piecesnsn/SRM_RoboMaster_Entropia/README.md

# SRM_RoboMaster_Entropia
In this repository, I will keep all the files ragarding SRM RoboMaster, team hardware, including supercapacitor.超级电容
上传的内容包括：
1）超级电容控制板.epro文件（使用嘉立创）
2）超级电容控制板的多个PCB、原理图pdf文件
3）超级电容控制板控制代码。使用keil5编写
