piecesnsn/SRM_RoboMaster_Entropia/23-24season_SRM_SuperCapcitor/Hardware/SCAP_SCH.pdf

# CAN 通信

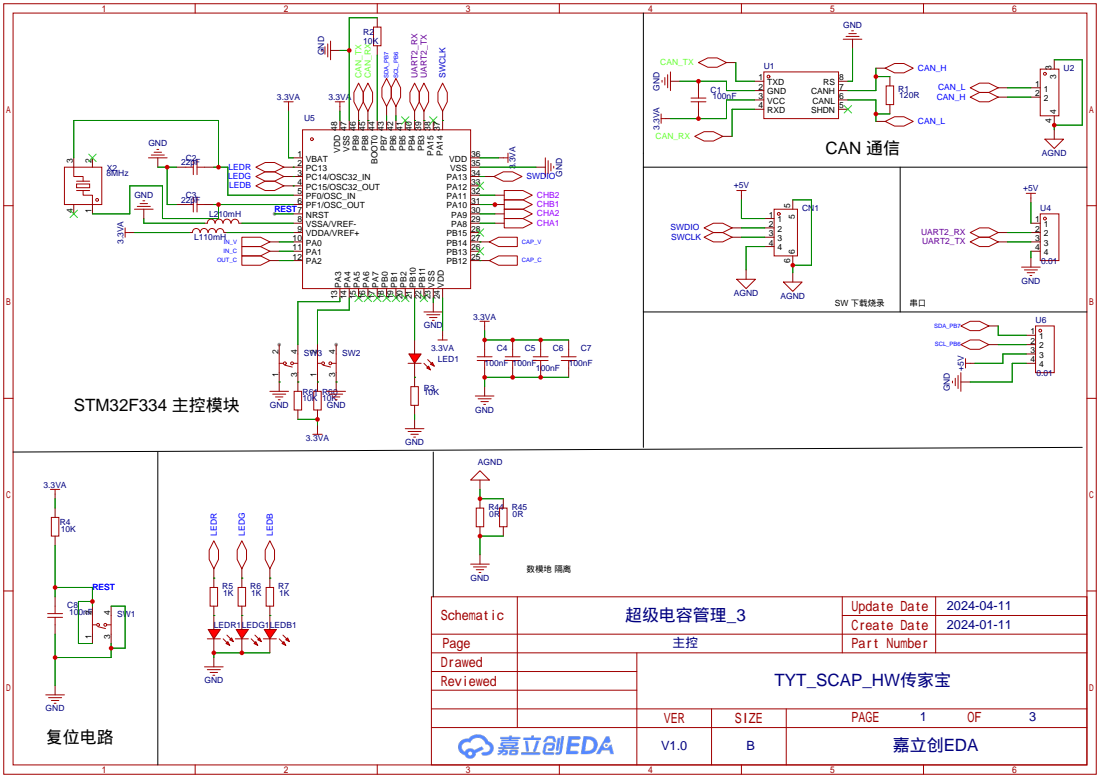
[picture p44: page 1]

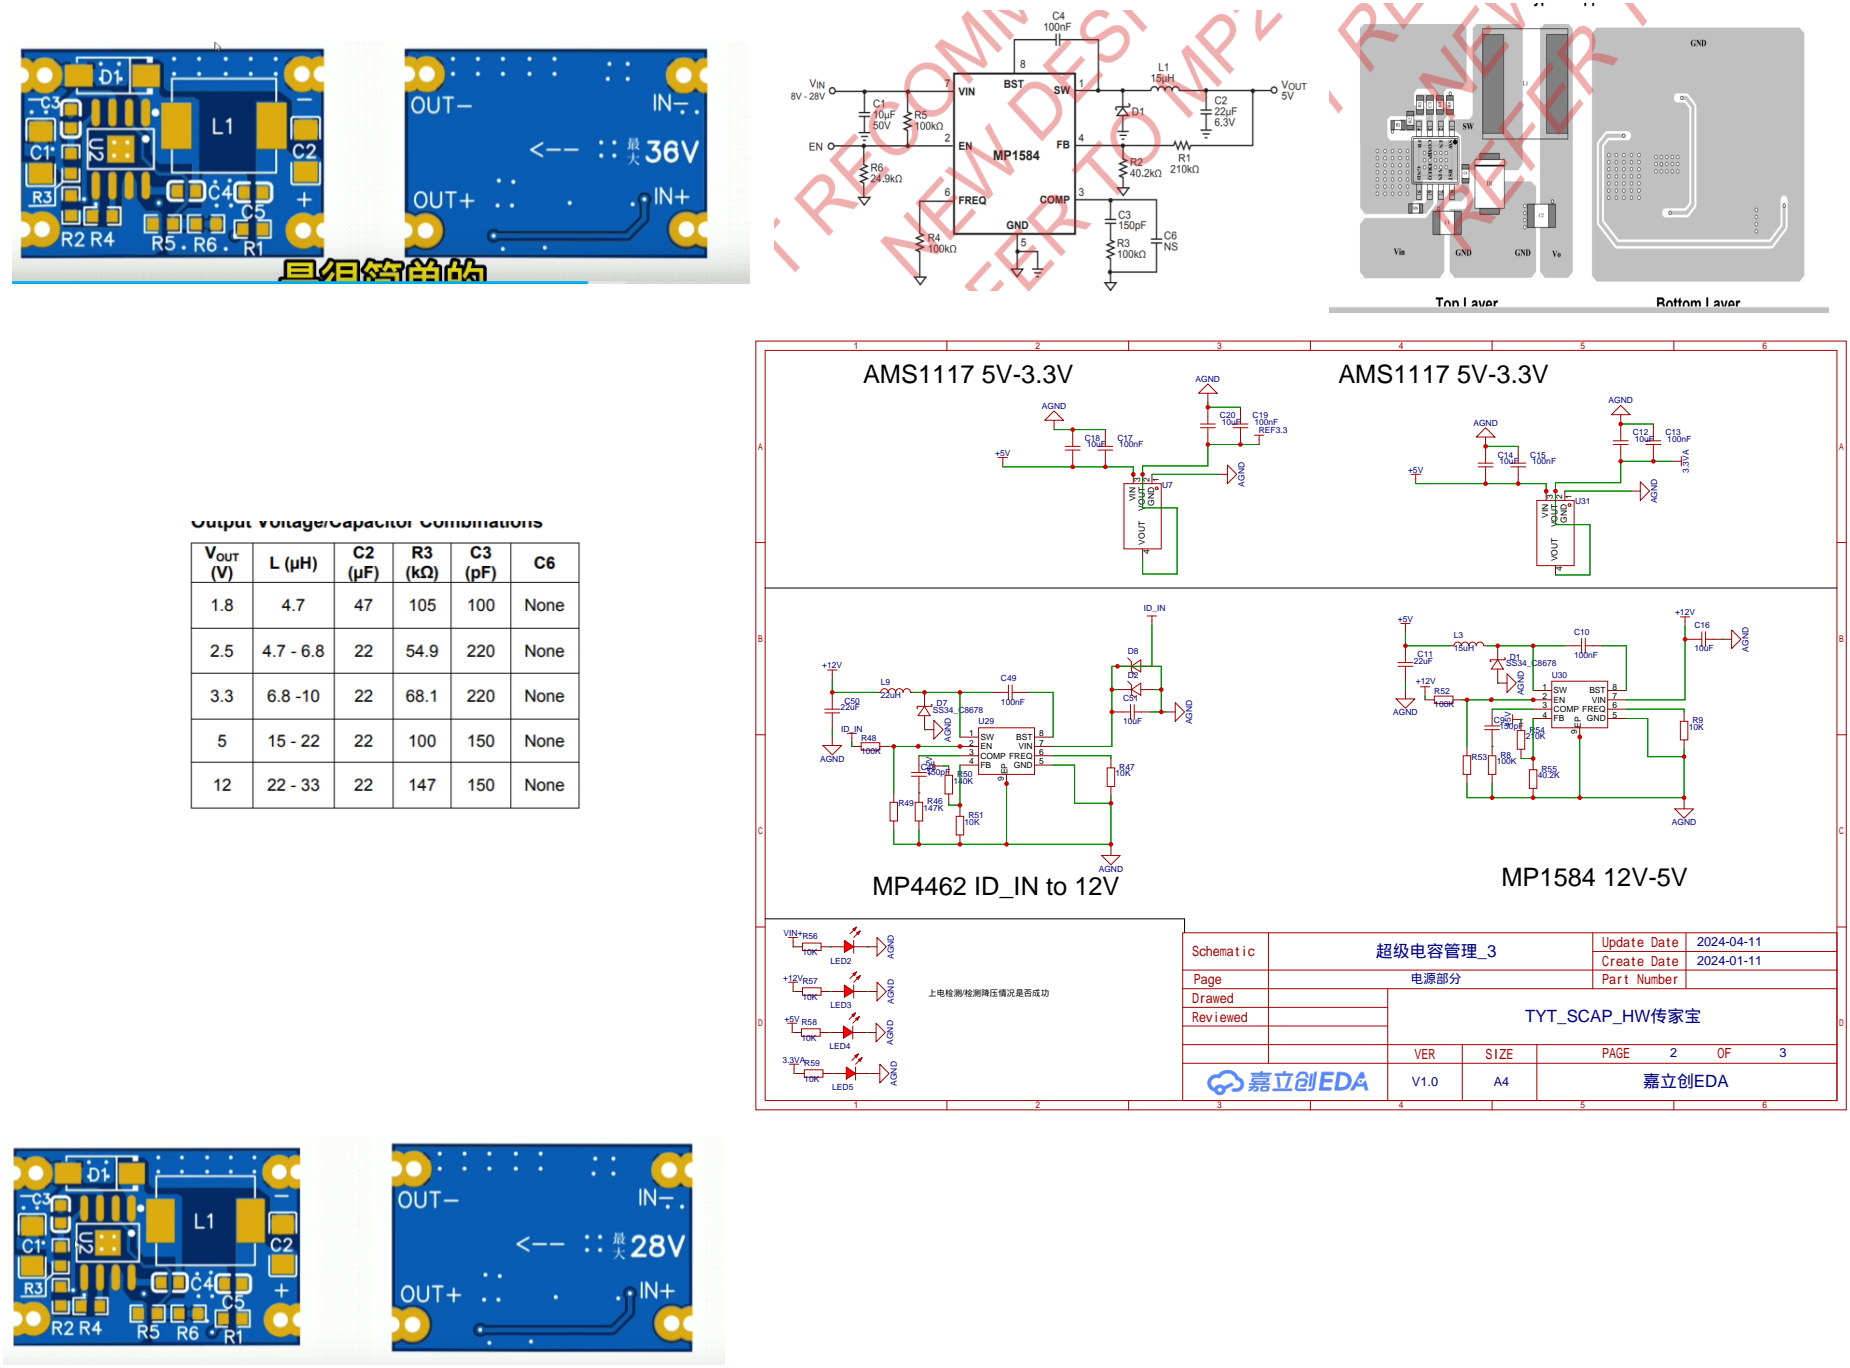
[picture p45: page 2]

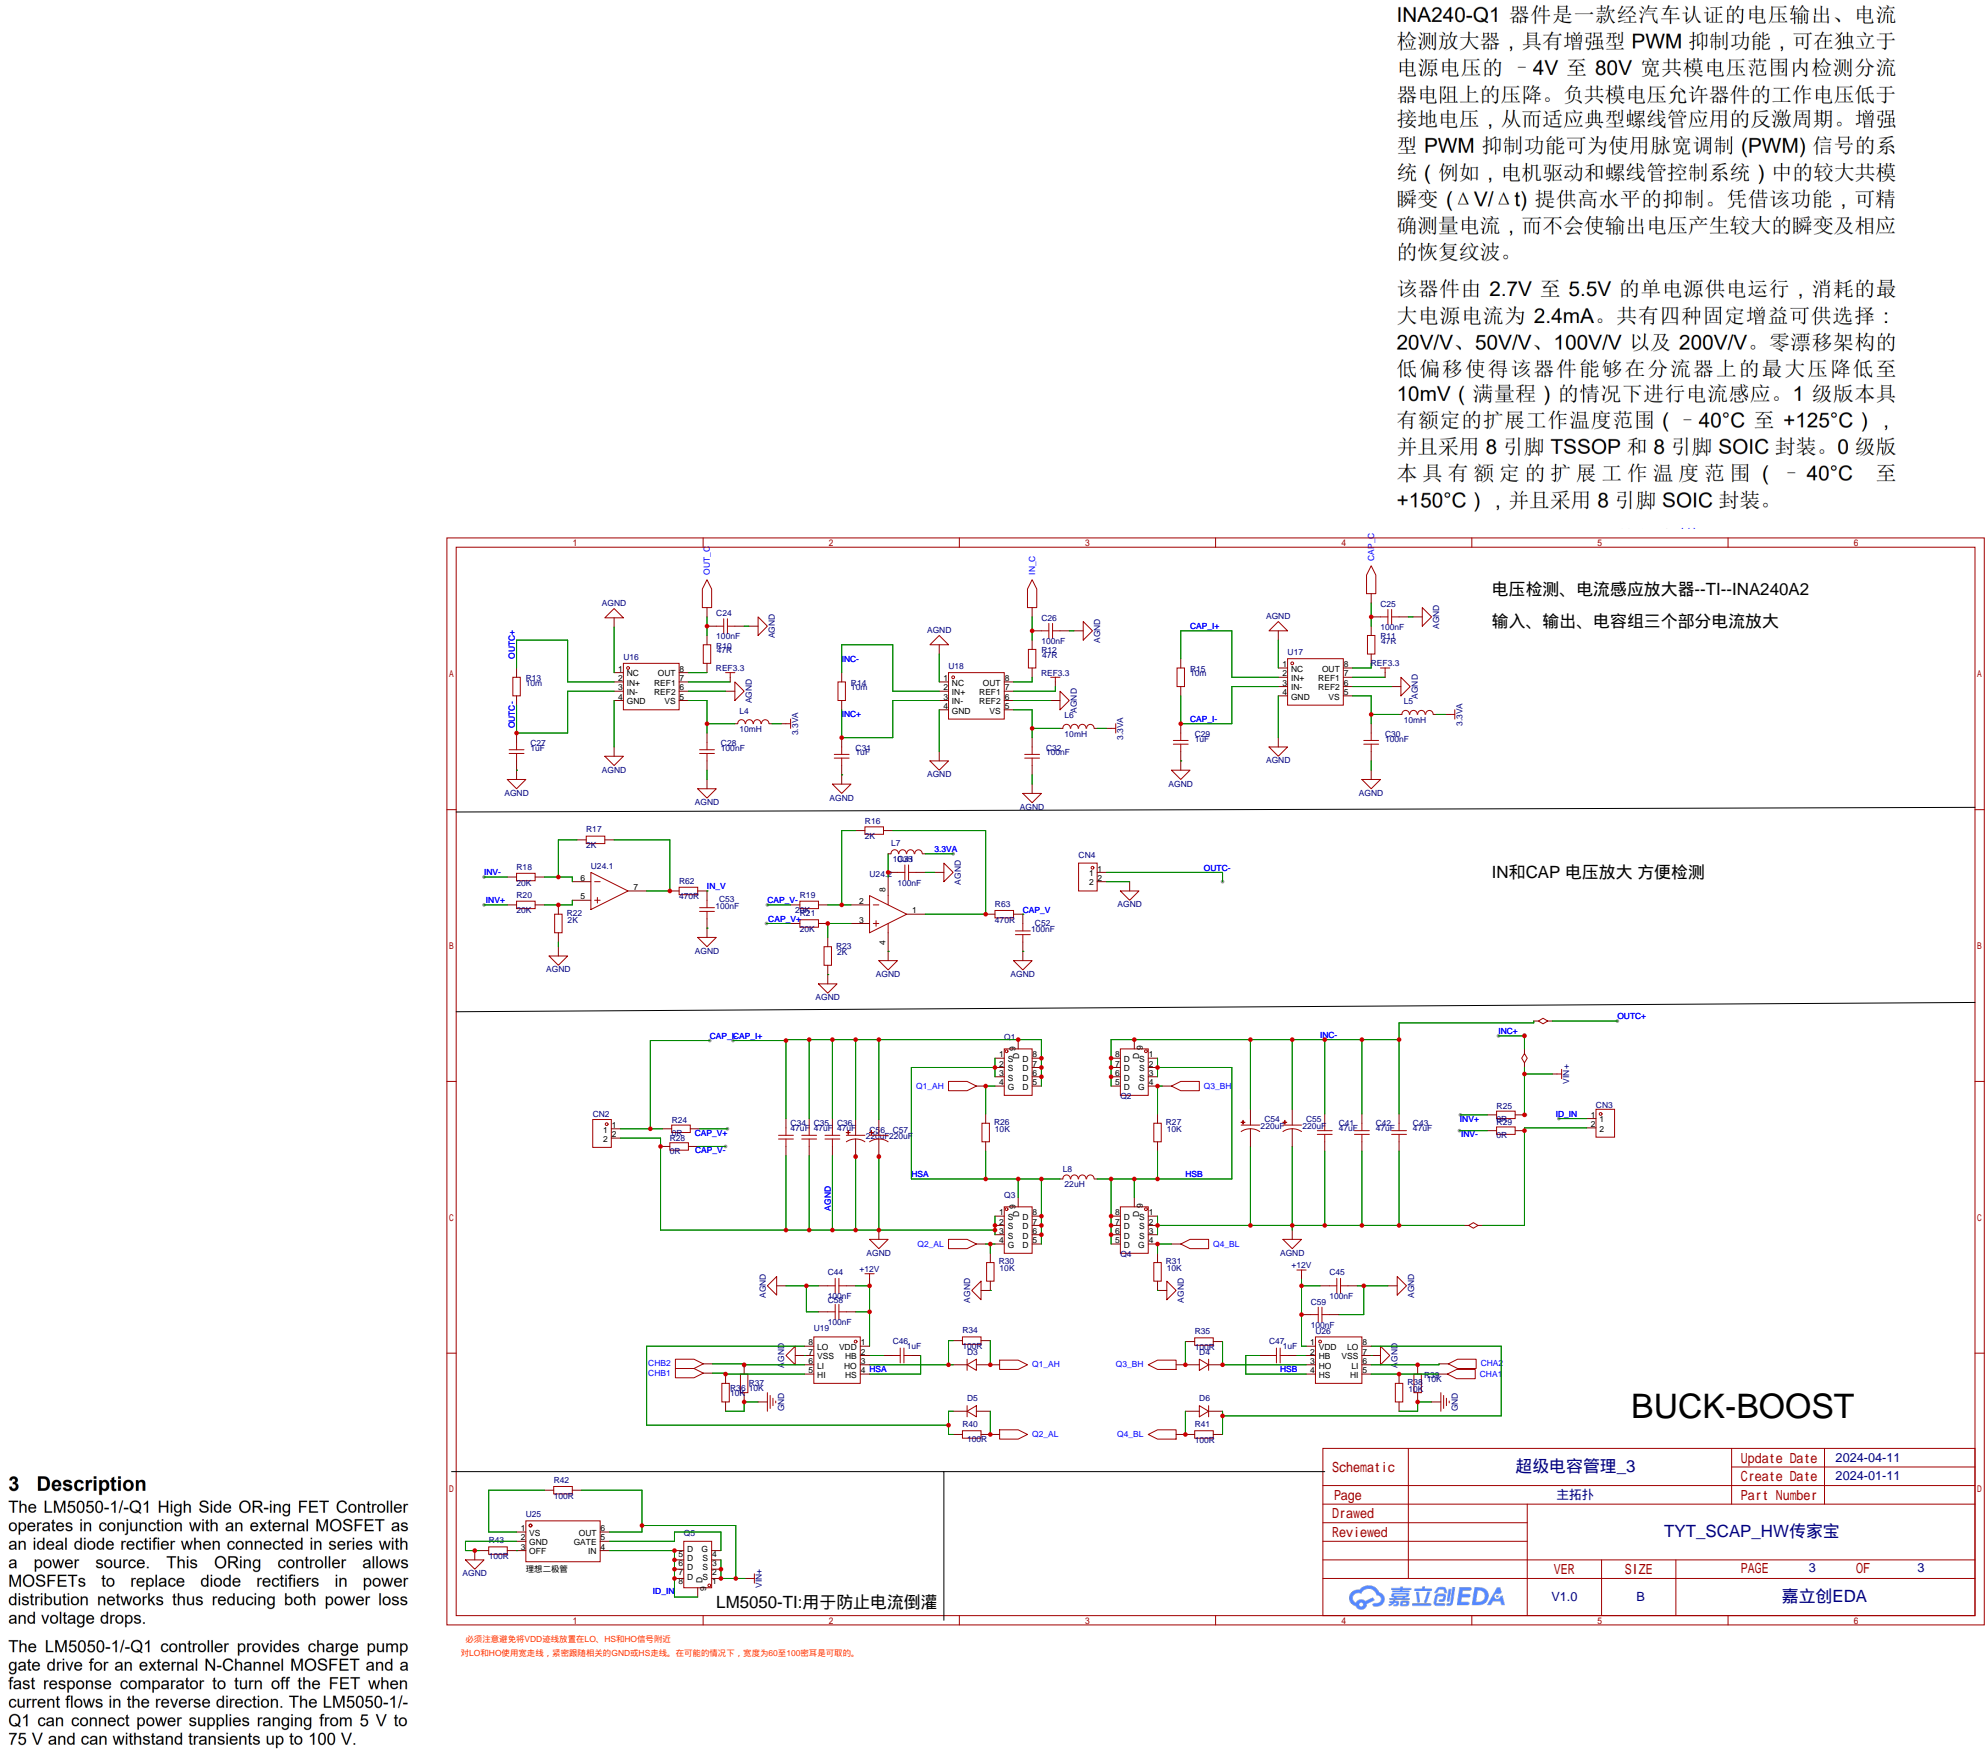
[picture p46: page 3]
