piecesnsn/SRM_RoboMaster_Entropia/23-24season_SRM_SuperCapcitor/Hardware/super_capacitor_main_circuit.pdf

# overload protection

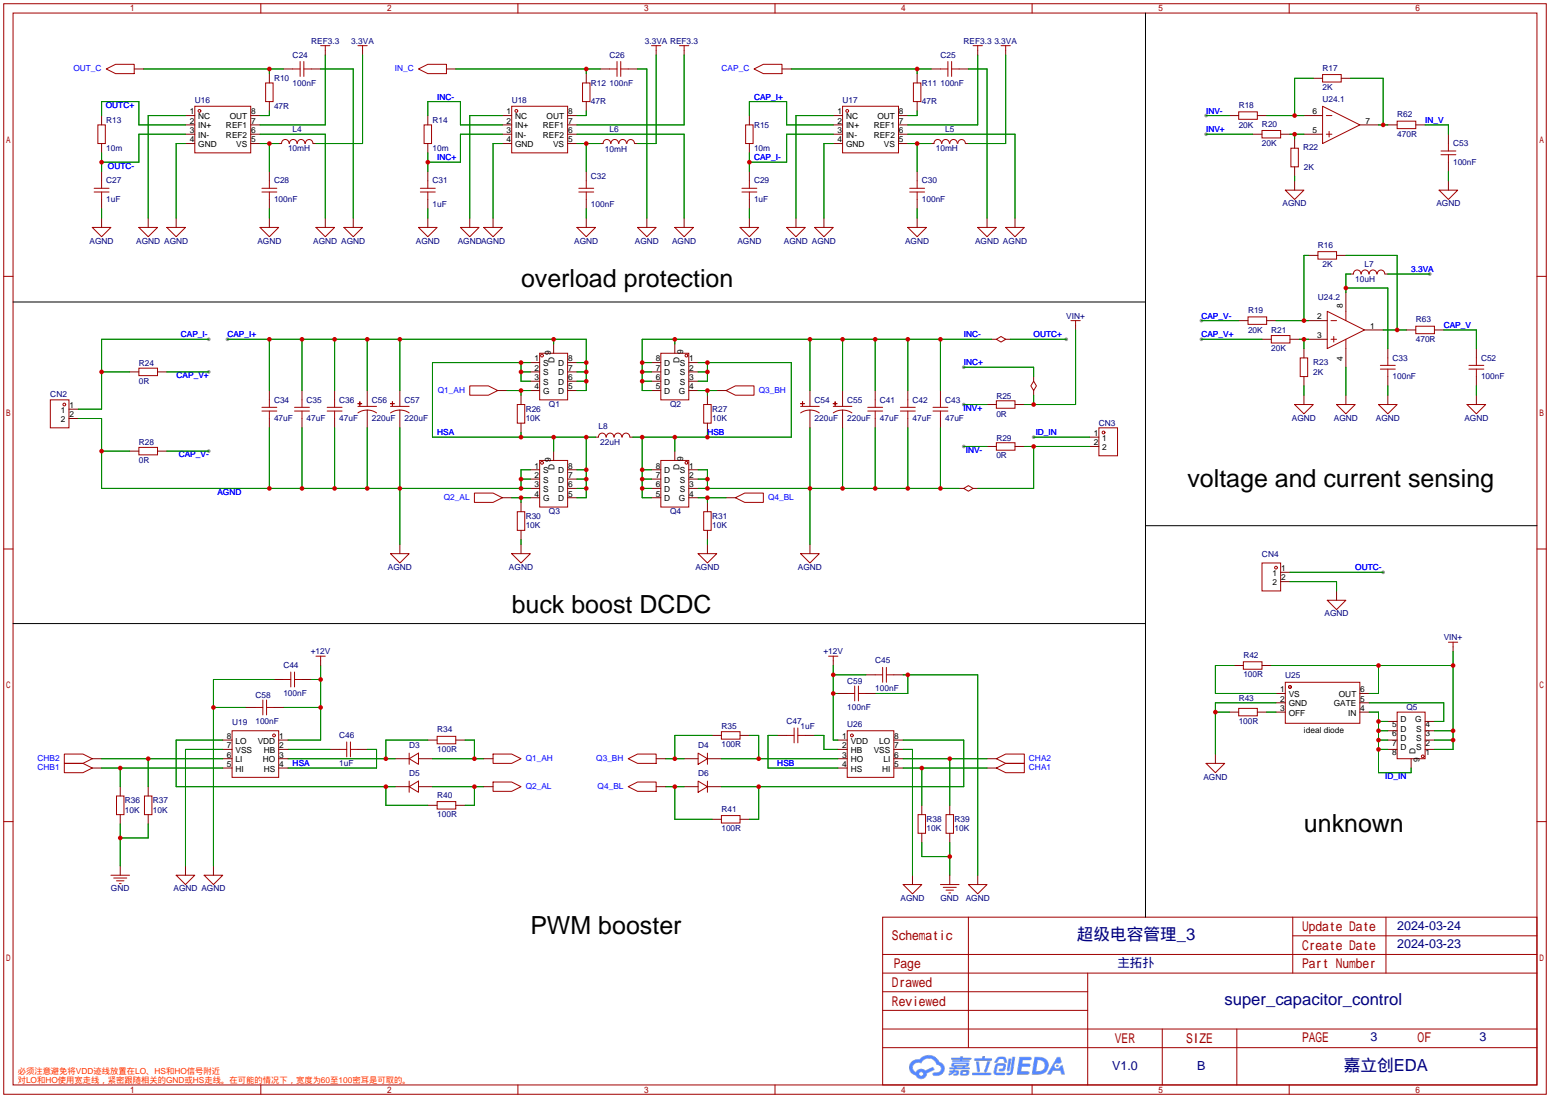
[picture p47: page 1]
