piecesnsn/SRM_RoboMaster_Entropia/23-24season_SRM_SuperCapcitor/Hardware/super_capacitor_main_control.pdf

# CAN controller

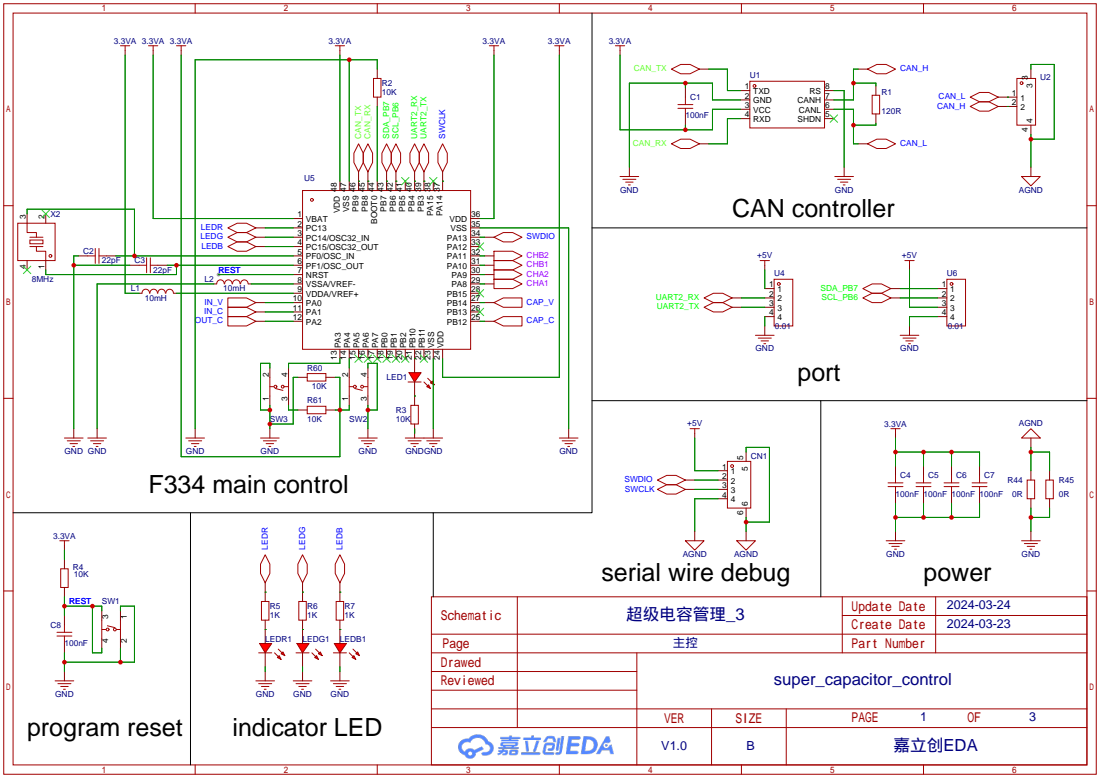
[picture p48: page 1]

22pF | | REST L2 10mH
