piecesnsn/SRM_RoboMaster_Entropia/23-24season_SRM_SuperCapcitor/Hardware/super_capacitor_power_supply.pdf

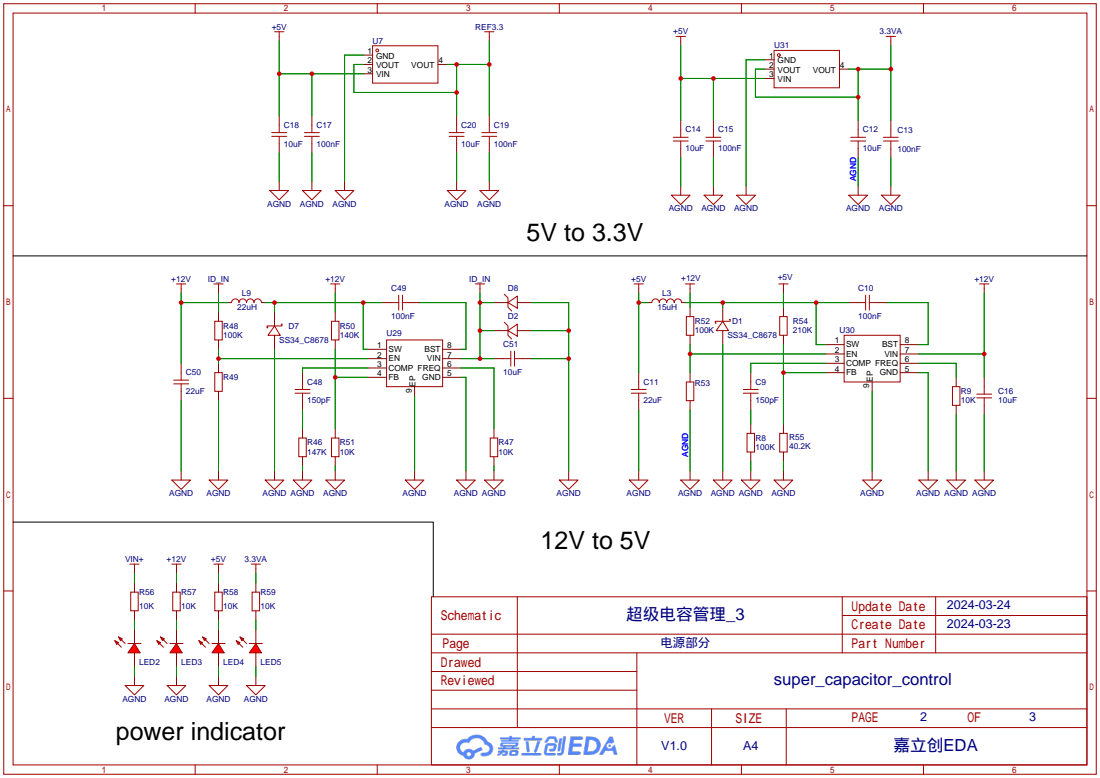
[picture p49: page 1]
