piecesnsn/SRM_RoboMaster_Entropia/(list of files, drawings)

Other design files:
23-24season_SRM_SuperCapcitor/Hardware/SRM_SuperCapacitor_S23_S24_.epro
